Xthanhduoc/DIYGamepad/PCB/imgaes/3DBOT.png

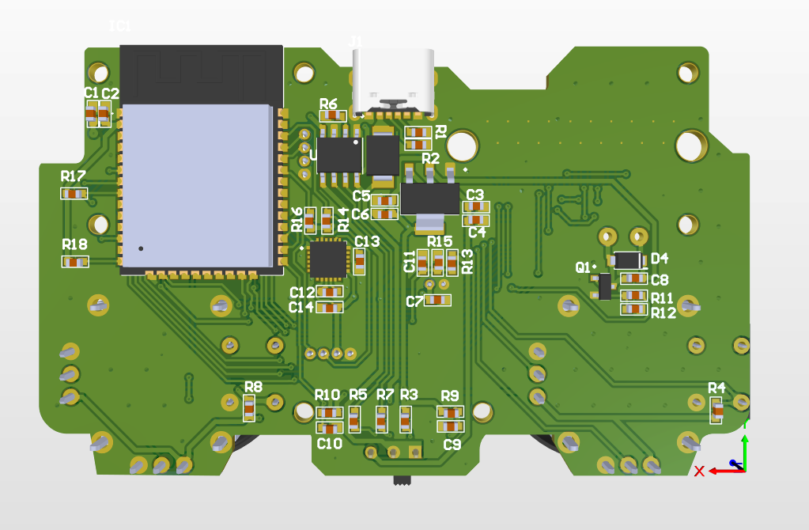
PCB/imgaes/3DBOT.png
