Xthanhduoc/DIYGamepad/PCB/imgaes/3DTOP.png

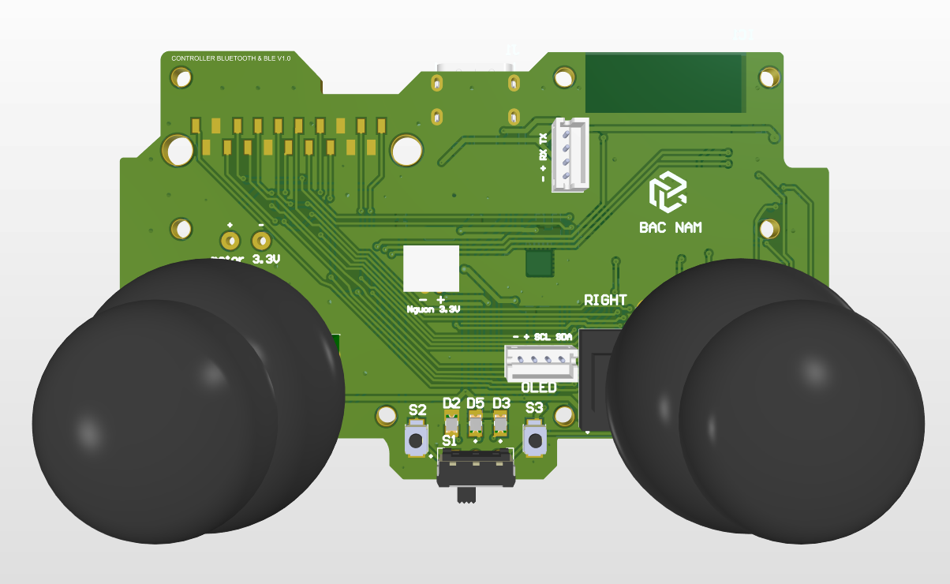
PCB/imgaes/3DTOP.png
