Xthanhduoc/DIYGamepad/PCB/imgaes/Bottoplayer.png

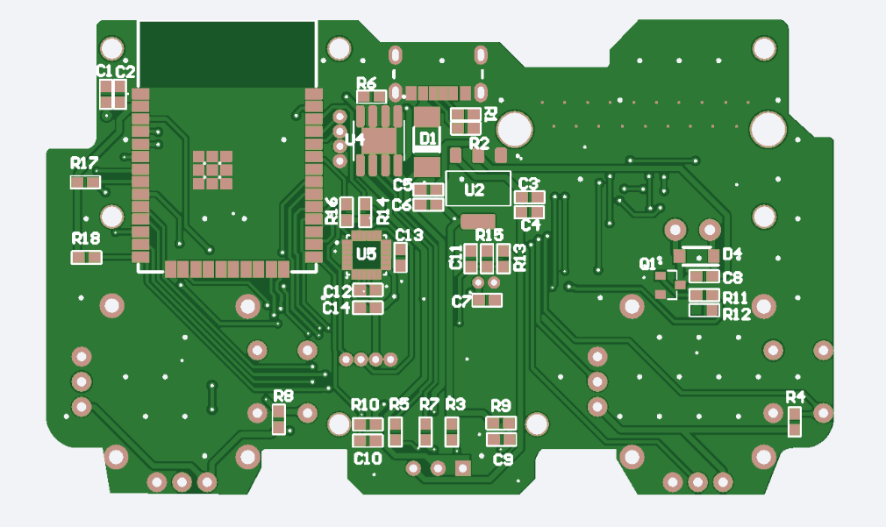
PCB/imgaes/Bottoplayer.png
