Xthanhduoc/DIYGamepad/PCB/imgaes/img.png

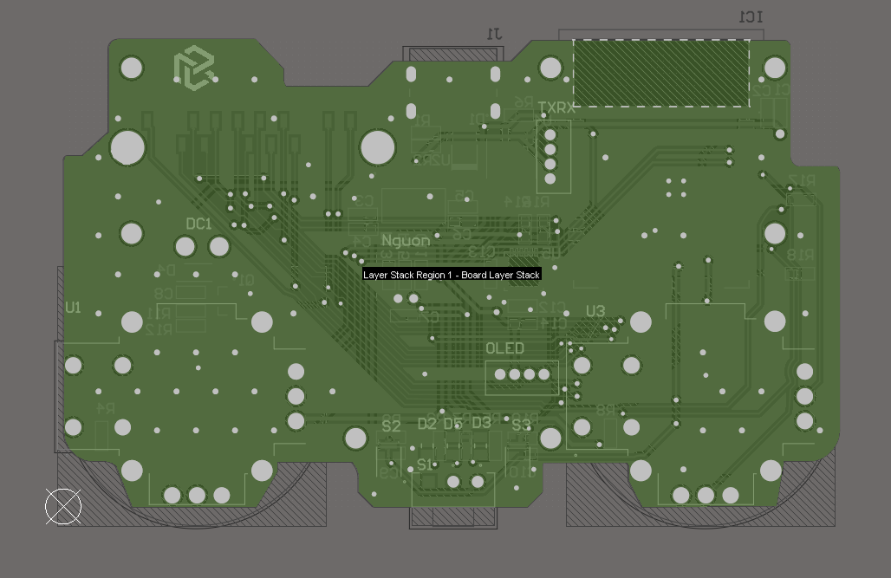
PCB/imgaes/img.png
