Xthanhduoc/DIYGamepad/PCB/imgaes/Toplayer.png

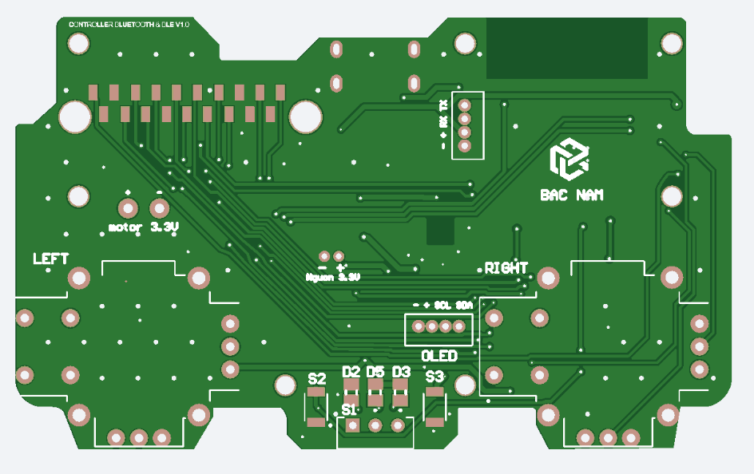
PCB/imgaes/Toplayer.png
