Xthanhduoc/DIYGamepad/PCB/PCB_Project.pdf

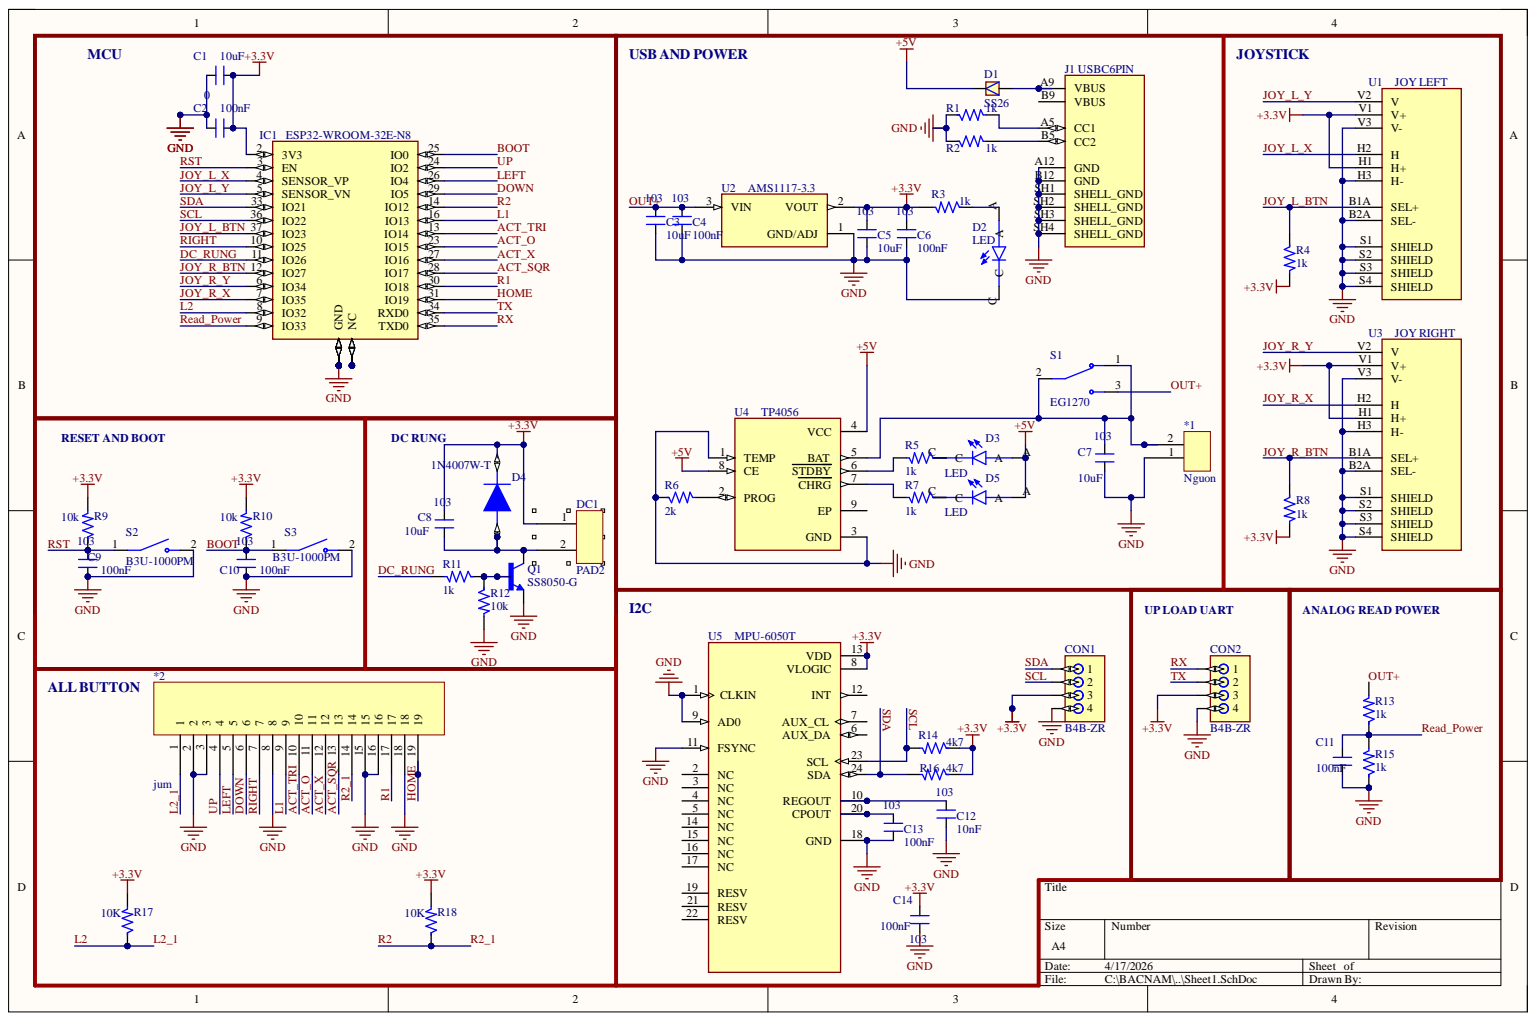
[picture p6: page 1]

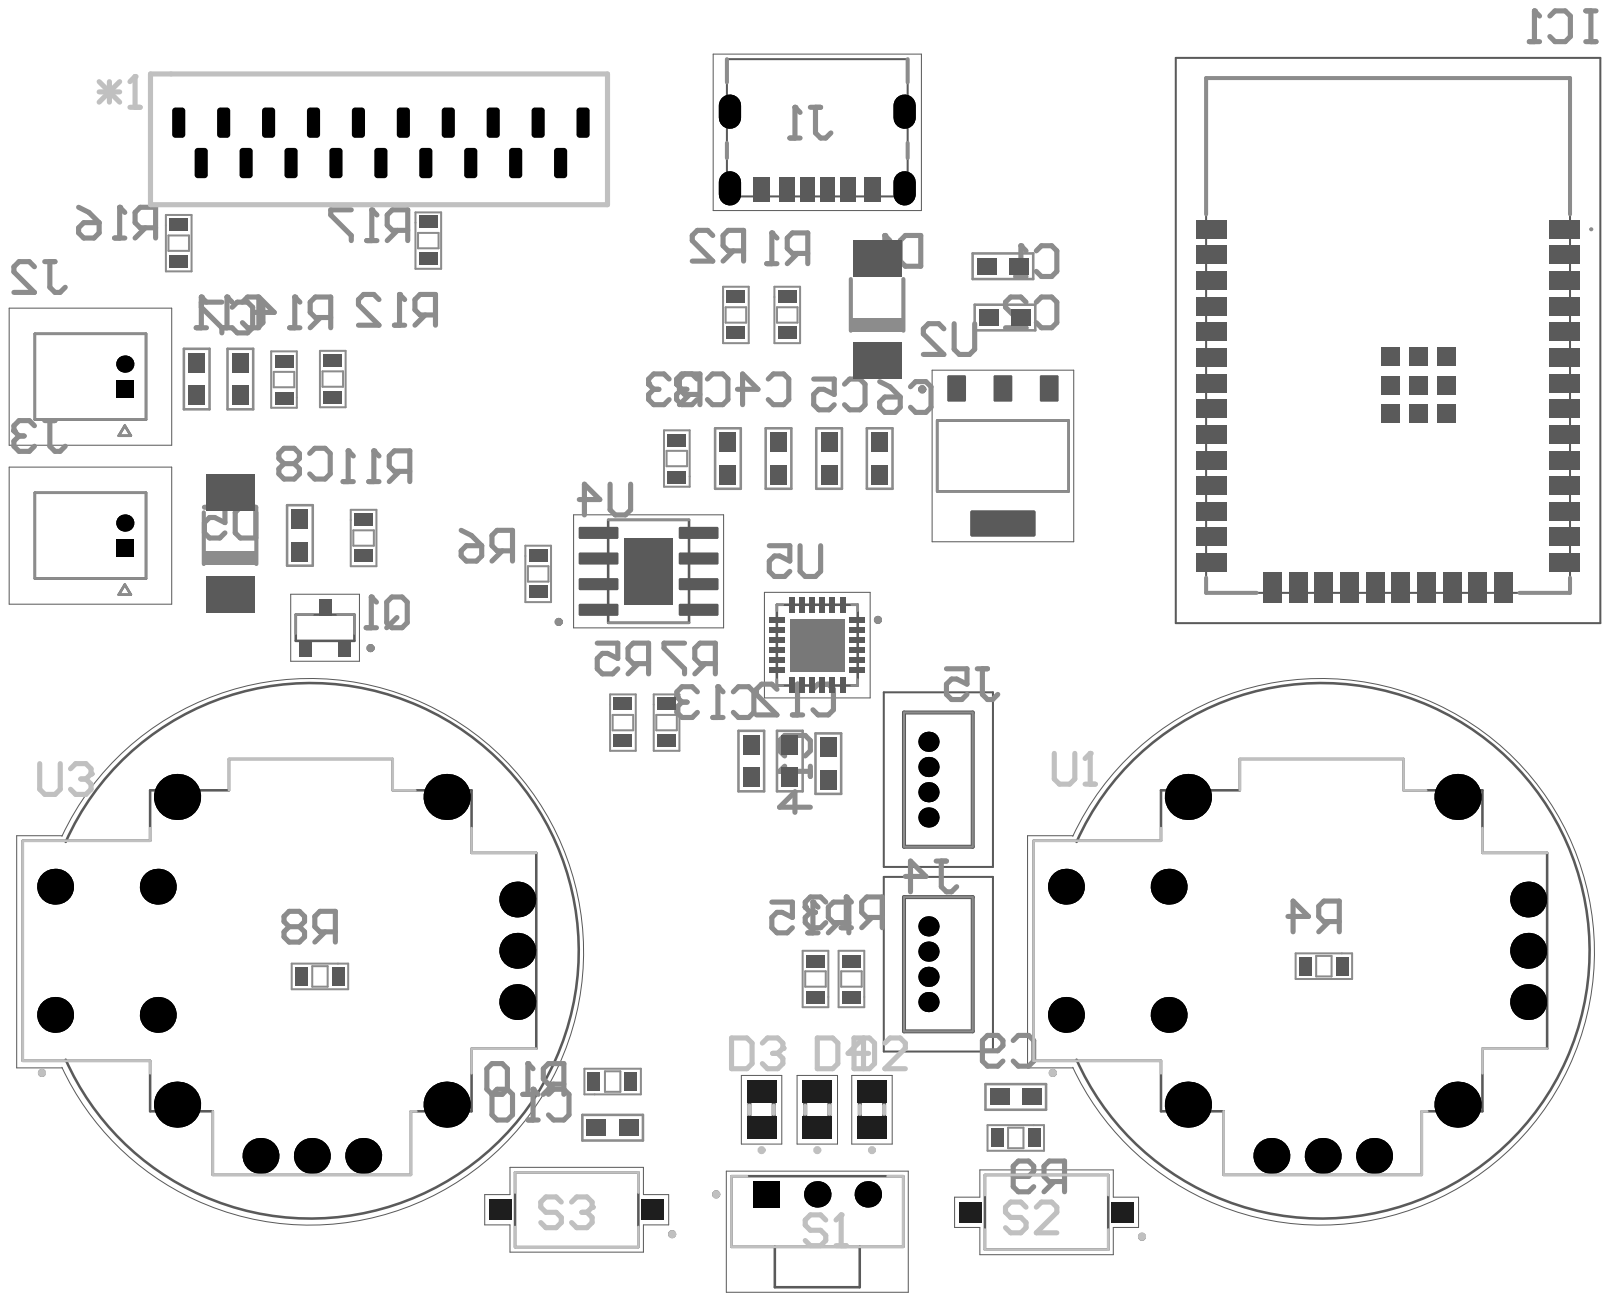
[picture p7: page 2]

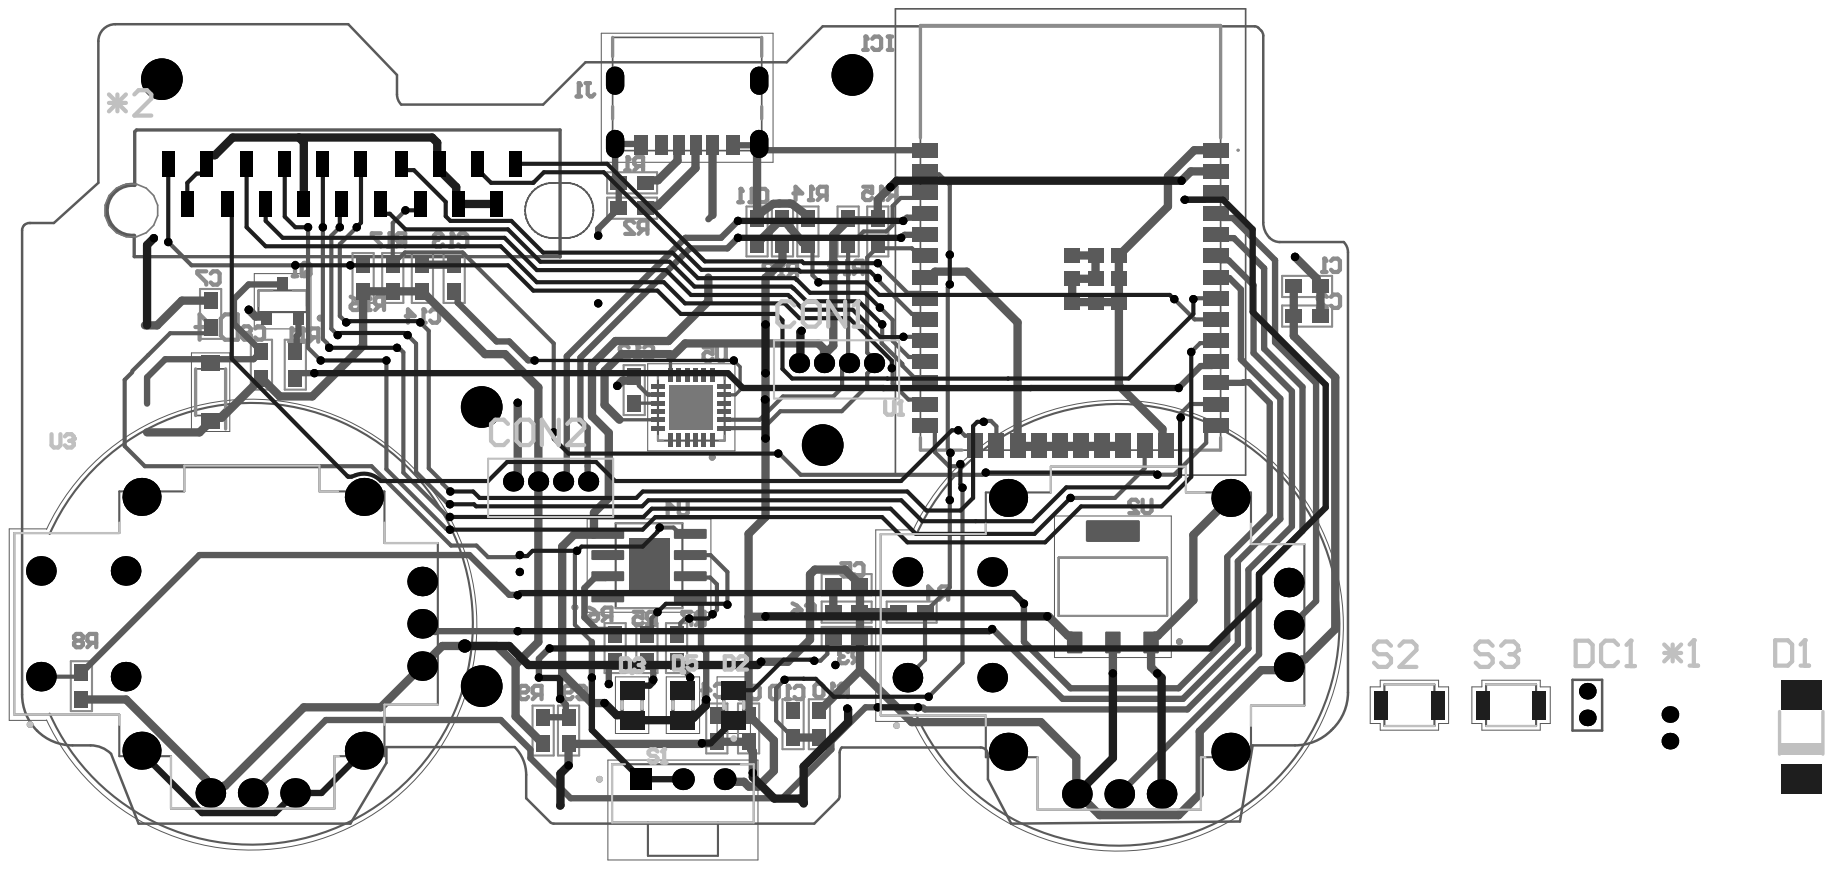
[picture p8: page 3]

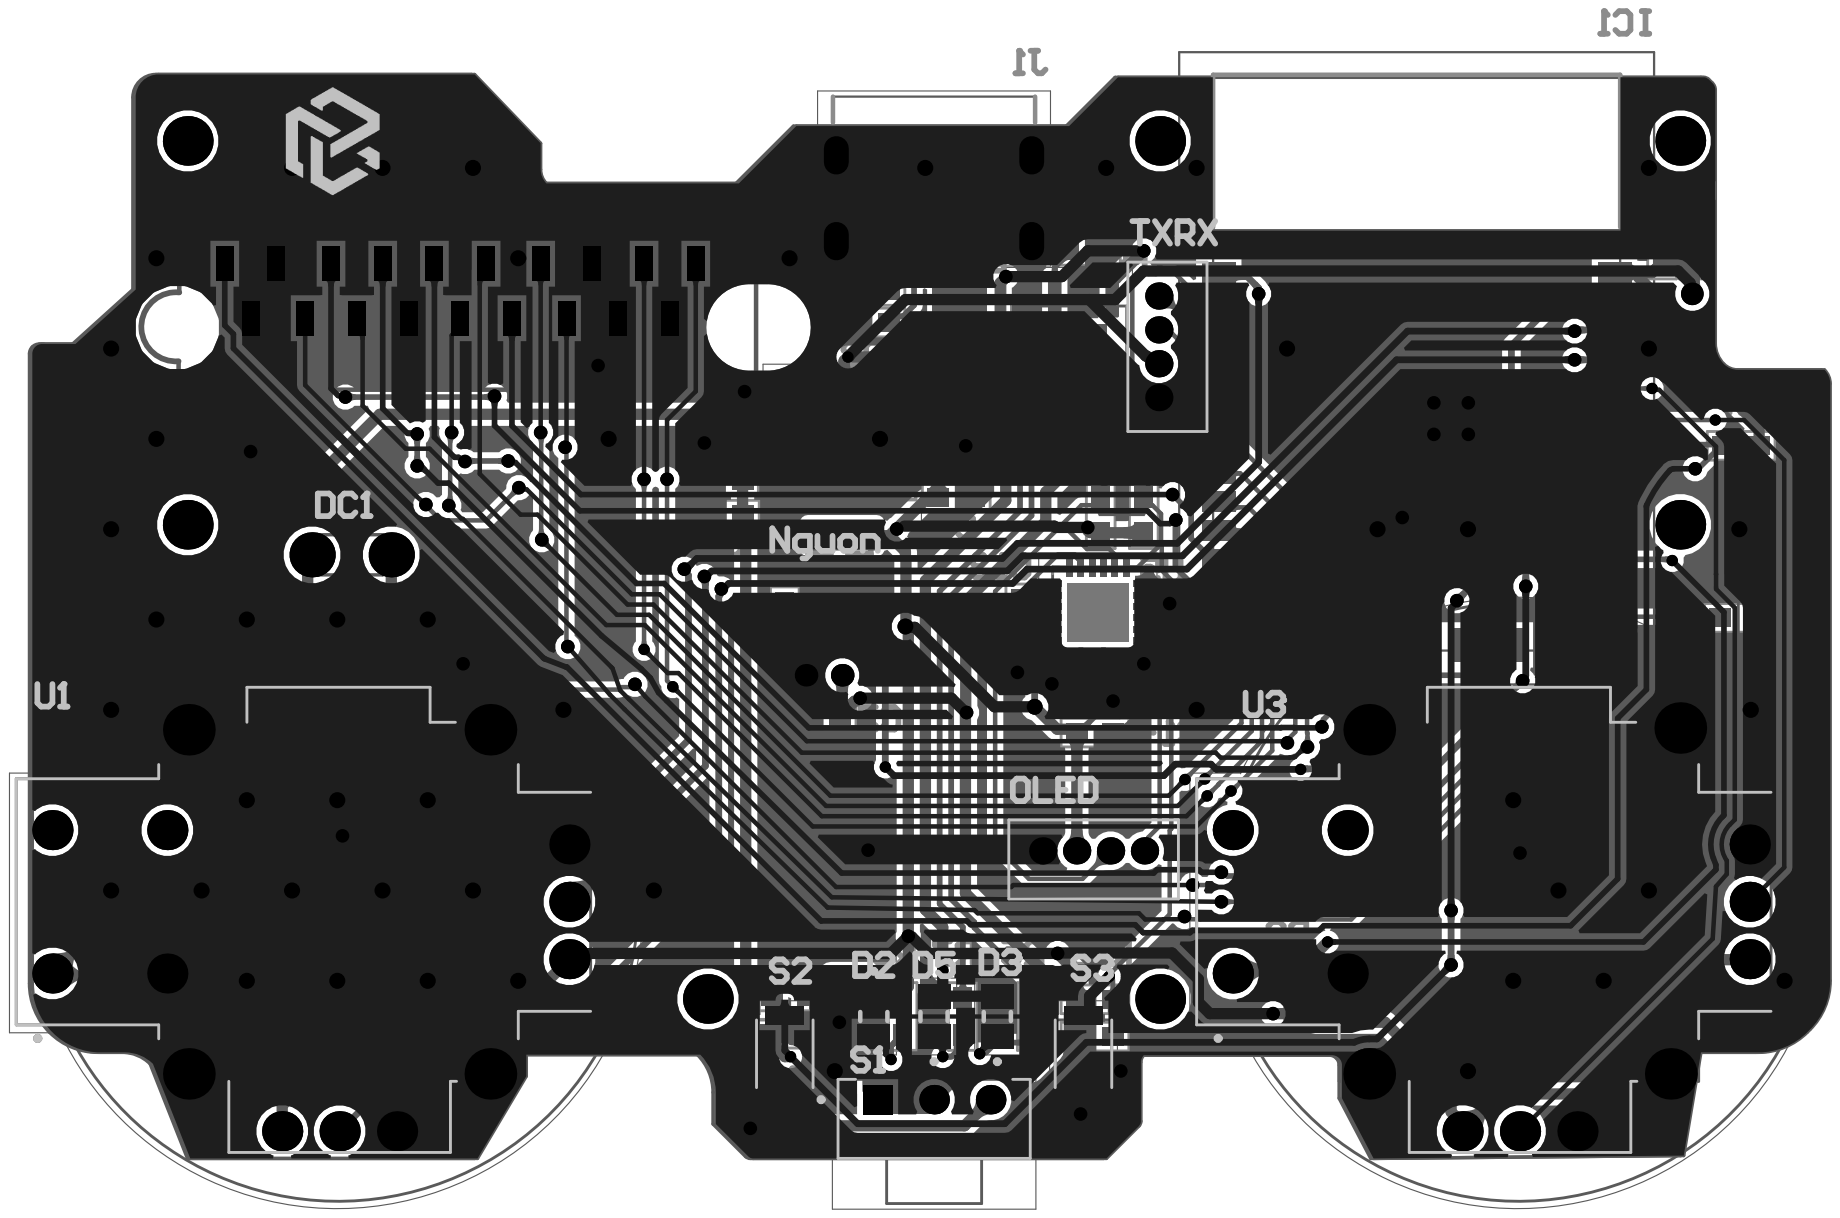
[picture p9: page 4]

Comment | Description | Designator | Footprint | LibRef | Quantity
Nguon | | *1 | PCBComponent_1 | Component_1 | 1
jum | | *2 | jum | jum | 1
10uF | Cap SMD | C1, C3, C5, C7, C8 | 0603 | CM | 5
100nF | Cap SMD | C2, C4, C6, C9, C10, C11, C13, C14 | 0603 | CM | 8
10nF | Cap SMD | C12 | 0603 | CM | 1
B4B-ZR | Connector Header Surface Mount 4 position 0.059 (1.50mm) | CON1, CON2 | B4B-ZR | B4B-ZR | 2
SS26 | Schottkydiod 2 A 60 V DO-214AA%3DSMB | Vishay SS26 @ Schottkydioder (Schottkydiod 2 A 60 V DO-214AA%3DSMB Dioder / SmÃ¥signals Schottky-dioder) | D1 | SS26 | SS26 | 1
LED | LED Uni-Color Green 4-Pin Chip 0805 T/R | D2, D3, D5 | LEDC2012X70N | 597-3305-607F | 3
1N4007W-T | Diode Standard 1000 V 1A Surface Mount SOD-123F | D4 | SODFL3818X130N | 1N4007W-T | 1
PAD2 | | DC1 | PAD2 | PAD2 | 1
ESP32-WROOM-32E-N8 | Bluetooth, WiFi 802.11b/g/n, Bluetooth v4.2 +EDR, Class 1, 2 and 3 Transceiver Module 2.4GHz ~ 2.5GHz PCB Trace Surface Mount | IC1 | ESP32WROOM32EN8 | ESP32-WROOM-32E-N8 | 1
USBC6PIN | Type C USB Charging Connector | J1 | GCT_USB4970-00-A_REVA | USB4970-00-A_REVA | 1
SS8050-G | Bipolar (BJT) Transistor NPN 25 V 1.5 A 100MHz 300 mW Surface Mount SOT-23-3 | Q1 | TRANS_SS8050-G | SS8050-G | 1
1k | Resistor 1/4W | R1, R2, R3, R4, R5, R7, R8, R11, R13, R15 | 0603 | R | 10
2k | Resistor 1/4W | R6 | 0603 | R | 1
10k | Resistor 1/4W | R9, R10, R12, R17, R18 0603 | | R | 5
4k7 | Resistor 1/4W | R14, R16 | 0603 | R | 2
EG1270 | Slide Switch, EG Series, SPDT, Non-Shorting, ON-ON, 300mA DC, 6VDC, R/A, PC | E-Switch EG1270 | S1 | SW_EG1270 | EG1270 | 1
B3U-1000PM | Top, w/o Boss 1k Reel | Omron Electronic Components B3U-1000PM | S2, S3 | SW_B3U-1000PM | B3U-1000PM | 2
JOY LEFT | Thumb Joystick | U1 | XDCR_COM-09032 | COM-09032 | 1
AMS1117-3.3 | 1A LOW DROPOUT VOLTAGE REGULATOR U2 | | SOT229P700X180-4N | AMS1117-5.0 | 1
JOY RIGHT | Thumb Joystick | U3 | XDCR_COM-09032 | COM-09032 | 1
TP4056 | Complete single cell Li-Ion battery with a constant current / constant voltage linear charger | U4 | SOP127P600X175-9N | TP4056 | 1
MPU-6050T | 3-Axis Gyro+3-Axis Accelerometer | U5 | QFN50P400X400X95-24N | MPU-6050T | 1
