Xthanhduoc/DIYGamepad/(commit log)

2026-04-17 PUSH PCB
2026-04-17 cập nhật thành tên main cho file firmware
